angu-software/A2Robot/docs/A2Robot.png

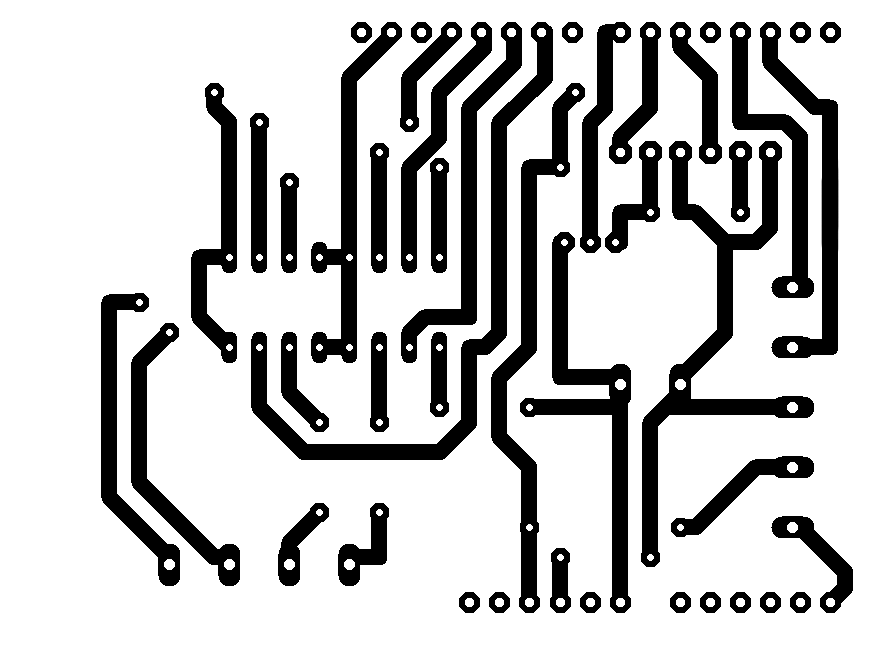
docs/A2Robot.png
