angu-software/A2Robot/docs/doku/img/schaltung.png

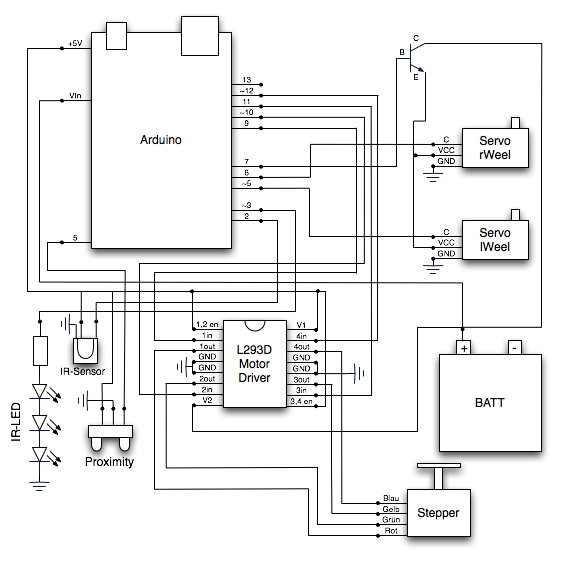
docs/doku/img/schaltung.png
