angu-software/A2Robot/docs/schematic.pdf

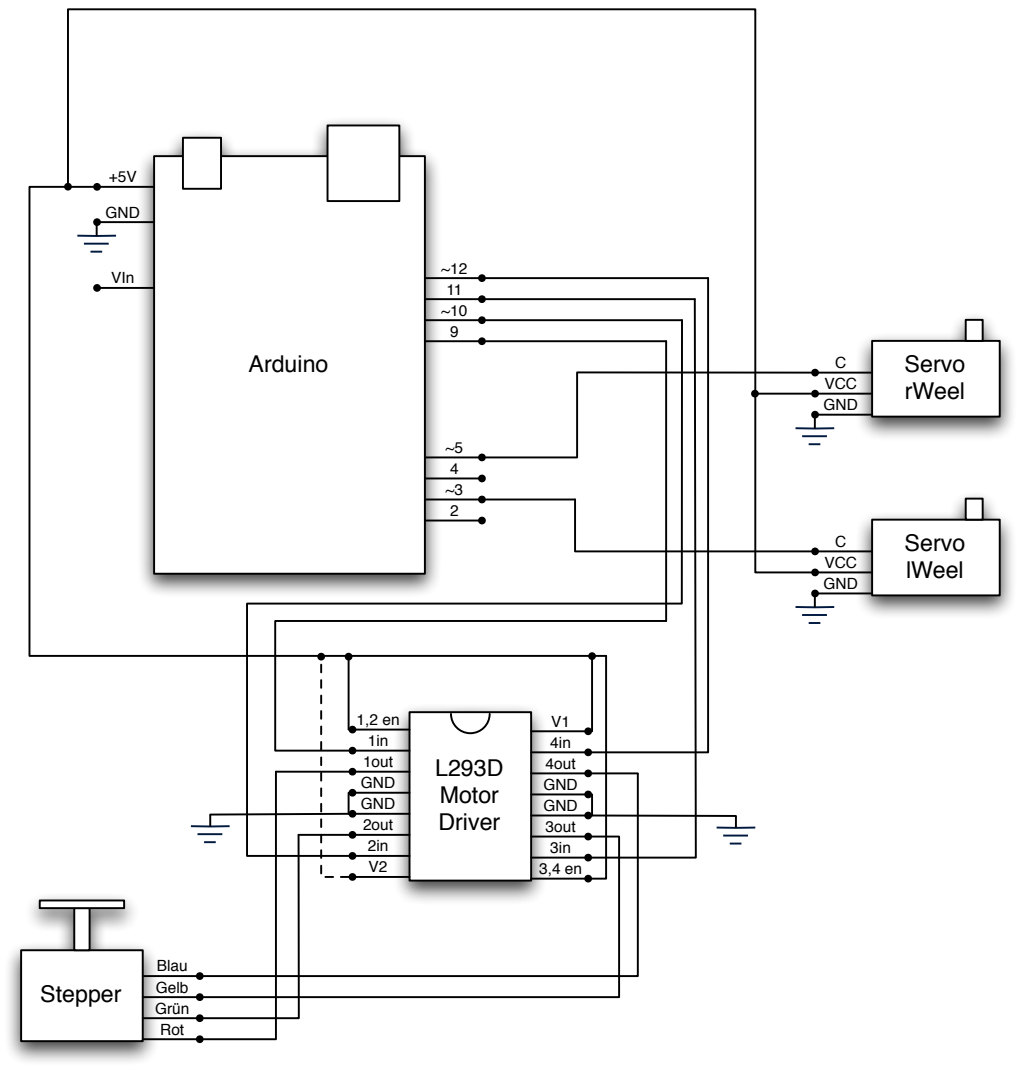
[picture p8: page 1]
GND; Servo rWeel GND; VCC; Servo lWeel GND; Arduino; Stepper; Rot; Grün; Gelb; Blau; L293D Motor Driver; 3out; 4out; 2out; 1out; VIn
