angu-software/A2Robot/docs/177577-da-01-en-IR_EMPFAENGER_MODUL_TBA.pdf

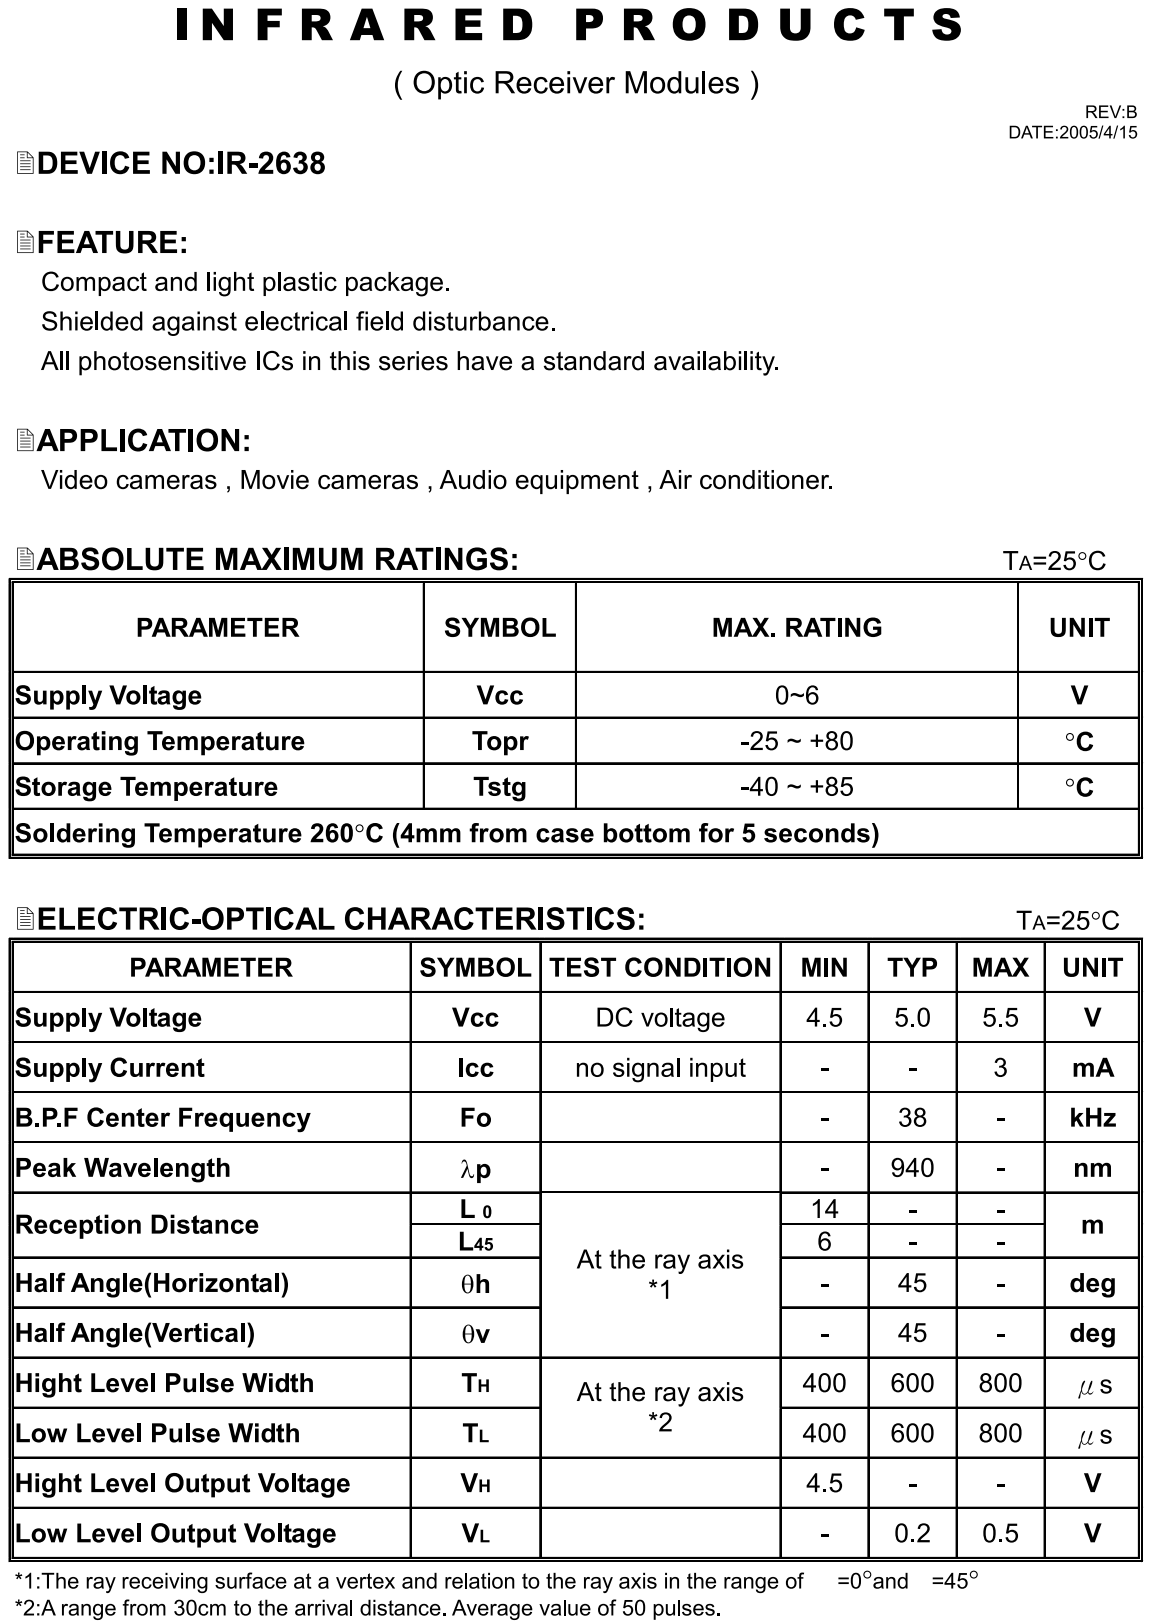
[picture p9: page 1]

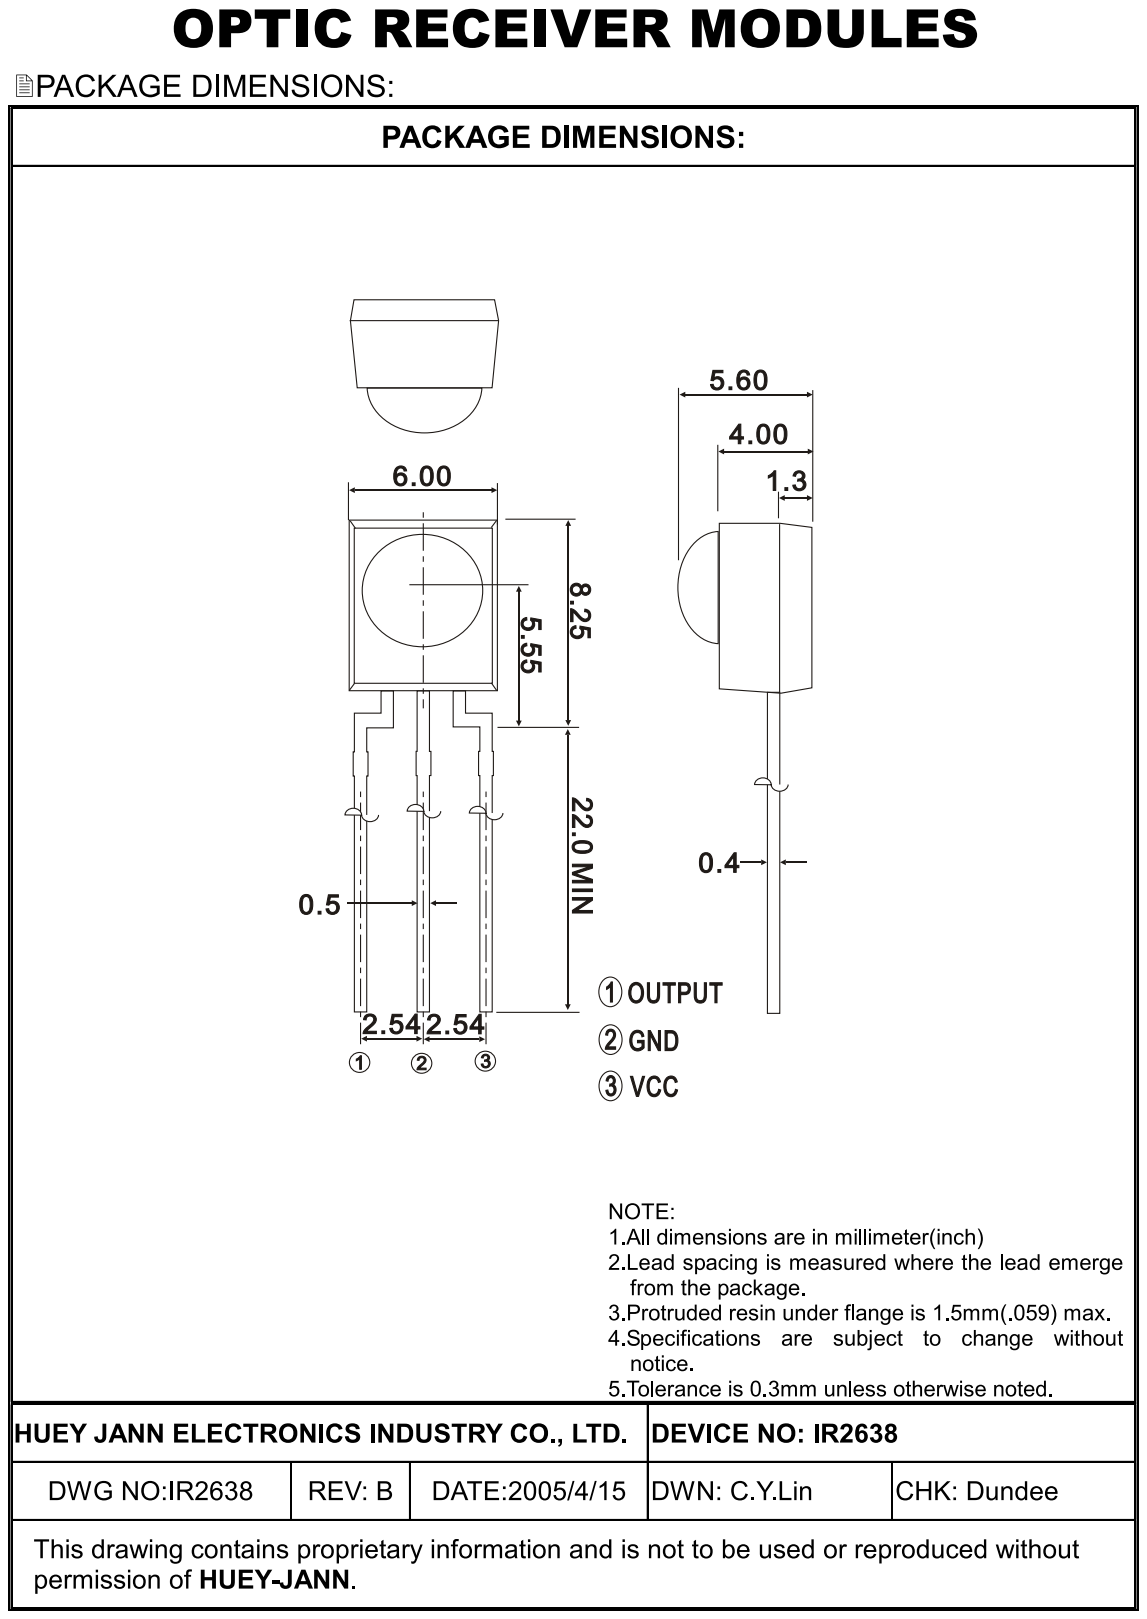
[picture p10: page 2]
