angu-software/A2Robot/docs/doku/img/kompassAufbau.png

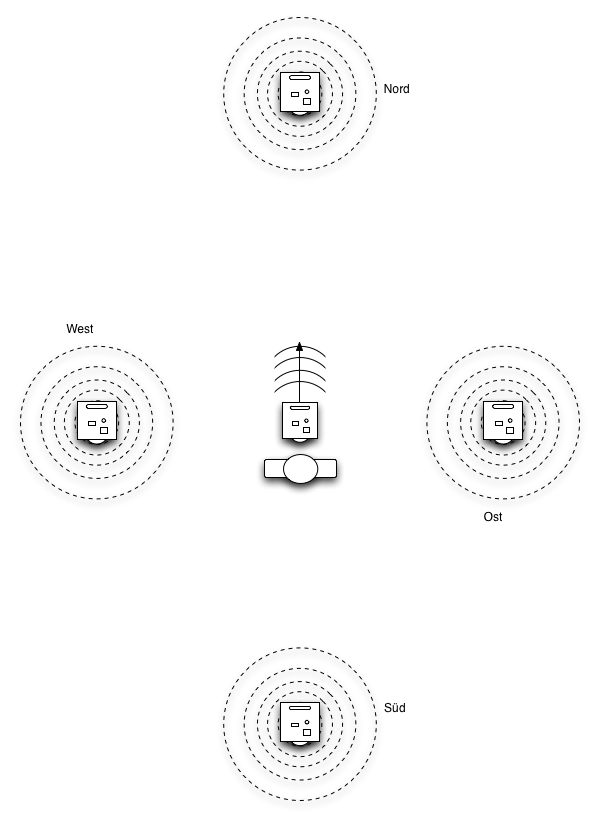
docs/doku/img/kompassAufbau.png
